vals55/eMeter32/hardware/comparator-board/README.ru.md

# Плата компараторов

[English](README.md) | Русский

Плата импульсных входов для eMeter32. Она преобразует импульсные выходы электросчётчиков в чёткие логические сигналы для ESP32. Основа платы — сдвоенный компаратор **LM393**: по одному компаратору на канал энергии (**E1** и **E2**).

## Как это работает

Электросчётчик сообщает о потреблённой энергии импульсами (например, выход S0 или оптический светодиод). Компаратор превращает эти импульсы в чёткий цифровой сигнал, а ESP32 считает их на аппаратном модуле PCNT. Энергия вычисляется по формуле `кВт·ч = импульсы / константа`, где константа (импульсов на кВт·ч) задаётся в настройках устройства (по умолчанию 3200).

## Схема

Схема платы компараторов

Нажмите на изображение, чтобы открыть схему в PDF.

## Подключение к ESP32

Выходы платы подключаются к выводам, заданным в [`board_config.h`](../../components/board_config/include/board_config.h):

| Сигнал | Вывод ESP32 |
|---|---|
| Выход канала E1 | GPIO 32 |
| Выход канала E2 | GPIO 33 |

У LM393 выходы с открытым коллектором, поэтому прошивка включает внутреннюю подтяжку на обоих входах (`PULSE_PULL_UP`). Счётчик использует аппаратный фильтр помех 10 мкс (`PULSE_GLITCH_NS`) и по умолчанию считает передний фронт (`PULSE_COUNT_FALLING`). Подробнее — в компоненте [`pulse_counter`](../../components/pulse_counter).

## Файлы

| Файл | Описание |
|---|---|
| [`schematic/Schematic_Comparator_2026-10-16.pdf`](schematic/Schematic_Comparator_2026-10-16.pdf) | Принципиальная схема (PDF), от 16.10.2026 |
| [`schematic/Schematic_Comparator_2026-10-16.png`](schematic/Schematic_Comparator_2026-10-16.png) | Принципиальная схема (изображение для README) |
| [`pcb/Gerber_Comparator_PCB_Comparator_2026-10-04.zip`](pcb/Gerber_Comparator_PCB_Comparator_2026-10-04.zip) | Gerber-файлы для производства платы, от 04.10.2026 |

Номиналы компонентов указаны на схеме. Исходники проекта платы в репозиторий не включены.

## Заказ и сборка платы

1. Загрузите Gerber-архив из [`pcb/`](pcb) на производство печатных плат, не распаковывая его (большинство сервисов принимает zip).
2. Закажите компоненты, указанные на [схеме](schematic/Schematic_Comparator_2026-10-16.pdf).
3. Спаяйте плату и проверьте выходы мультиметром или осциллографом, прежде чем подключать её к ESP32.

TODO: размер платы, число слоёв и толщина.

## Настройка счёта

- Число импульсов на кВт·ч указано на вашем счётчике (например, 3200 имп/кВт·ч). Введите его как **Meter constant** в портале настройки или в Home Assistant.
- Если вашему счётчику нужен другой фронт счёта, измените `PULSE_COUNT_FALLING` в `board_config.h`.
- Начальные показания счётчиков можно задать в портале настройки или сущностями **Set energy E1/E2** в Home Assistant.

## Замечания

- Перед подключением проверьте полярность и уровни напряжения импульсных выходов ваших счётчиков: они не должны превышать допустимые для компаратора.
- Плата может подключаться к цепям, близким к **230 В**. Изолируйте её и собирайте, только если знаете правила электробезопасности.

## Лицензия

Файлы проекта платы распространяются под той же [лицензией MIT](../../LICENSE), что и проект.
