vals55/eMeter32/hardware/enclosure/README.ru.md

# Корпус

[English](README.md) | Русский

Корпус для счётчика энергии eMeter32, напечатанный на 3D-принтере. В нём размещаются плата ESP32, модуль PZEM-004T, плата импульсных входов (компараторов) и OLED-дисплей. Корпус рассчитан на обычный FDM-принтер.

eMeter32 в корпусе

> [!WARNING]
> В корпусе находятся детали, подключённые к сети **230 В**. Изолируйте сетевую проводку и отделите её от слаботочной части, а перед включением устройства закройте корпус.

## Файлы

Готовые к печати модели лежат в [`stl/`](stl):

| Файл | Деталь | Кол-во |
|---|---|---|
| [`Pzem-004t_v4_2026-assembly-case.stl`](stl/Pzem-004t_v4_2026-assembly-case.stl) | Корпус (основание) | 1 |
| [`Pzem-004t_v4_2026-assembly-cover.stl`](stl/Pzem-004t_v4_2026-assembly-cover.stl) | Крышка | 1 |
| [`Pzem-004t_v4_2026-assembly-lock.stl`](stl/Pzem-004t_v4_2026-assembly-lock.stl) | Фиксатор | 1 |

## Что размещается внутри

| Деталь | Примечание |
|---|---|
| Плата ESP32 (WEMOS D1 mini ESP32) | Основной контроллер, USB-порт должен оставаться доступным |
| Модуль PZEM-004T | Измерение сети, подключается к сетевой стороне |
| Плата импульсных входов (LM393) | См. [плату компараторов](../comparator-board/README.ru.md) |
| OLED SSD1306, 128×64 | Дисплей состояния |
| Кнопка | Открывает портал настройки (удержание 3 с) |

## Параметры печати

<!-- TODO: заполнить значениями, которые вы использовали -->

| Параметр | Значение |
|---|---|
| Материал | PLA / PETG (PETG лучше для тёплых мест) |
| Высота слоя | 0,2 мм |
| Периметры | 3 |
| Заполнение | 20 % |
| Поддержки | TODO |
| Ориентация | TODO |

## Сборка

1. Напечатайте три детали из [`stl/`](stl).
2. Очистите детали и примерьте платы до окончательной сборки.
3. Установите платы в корпус и закрепите их. TODO: крепёж и размеры.
4. Подключите провода по [распиновке](../../README.ru.md#распиновка).
5. Установите крышку и зафиксируйте её фиксатором. Убедитесь, что ничто не давит на сетевые клеммы.

Если дисплей установлен вверх ногами, установите `OLED_ROTATE_180` в `1` в [`oled.h`](../../components/oled/include/oled.h). У модуля жёлтая зона закреплена сверху, поэтому после поворота она оказывается снизу.

## Лицензия

Модели распространяются под той же [лицензией MIT](../../LICENSE), что и проект.
