vals55/eMeter32/main-readme-blocks.md

# Blocks for the main READMEs

Insert into `README.md` (section "Hardware", after the pinout table) and into `README.ru.md` (section "Аппаратная часть"). Roadmap: mark "Schematics and photos of the device" and "3D-printed enclosure" as done.

## README.md

### Assembly, enclosure and boards

eMeter32 assembled in the enclosure

**Comparator board schematic** (click to open the PDF):

Comparator board schematic

| Item | Location |
|---|---|
| Enclosure (STL models, print and assembly notes) | [`hardware/enclosure`](hardware/enclosure) |
| Comparator board description | [`hardware/comparator-board`](hardware/comparator-board) |
| Schematic (PDF) | [`hardware/comparator-board/schematic/Schematic_Comparator_2026-10-16.pdf`](hardware/comparator-board/schematic/Schematic_Comparator_2026-10-16.pdf) |
| Gerber files for PCB manufacturing | [`hardware/comparator-board/pcb/Gerber_Comparator_PCB_Comparator_2026-10-04.zip`](hardware/comparator-board/pcb/Gerber_Comparator_PCB_Comparator_2026-10-04.zip) |

## README.ru.md

### Сборка, корпус и платы

eMeter32 в корпусе

**Схема платы компараторов** (нажмите, чтобы открыть PDF):

Схема платы компараторов

| Что | Где |
|---|---|
| Корпус (STL-модели, заметки по печати и сборке) | [`hardware/enclosure`](hardware/enclosure/README.ru.md) |
| Описание платы компараторов | [`hardware/comparator-board`](hardware/comparator-board/README.ru.md) |
| Схема (PDF) | [`hardware/comparator-board/schematic/Schematic_Comparator_2026-10-16.pdf`](hardware/comparator-board/schematic/Schematic_Comparator_2026-10-16.pdf) |
| Gerber-файлы для производства платы | [`hardware/comparator-board/pcb/Gerber_Comparator_PCB_Comparator_2026-10-04.zip`](hardware/comparator-board/pcb/Gerber_Comparator_PCB_Comparator_2026-10-04.zip) |
