vals55/eMeter32/hardware/enclosure/stl/Pzem-004t_v4_2026-assembly-cover.stl

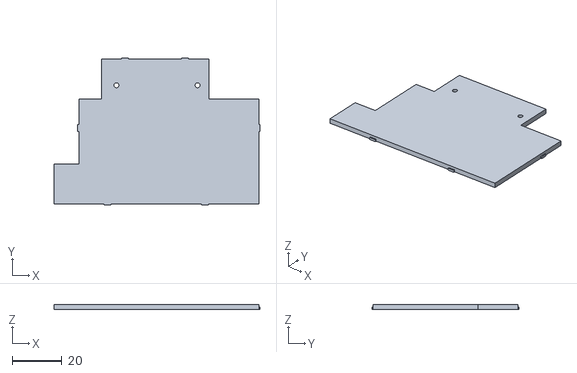
[picture p5: CAD file, 2026-10-18]
hardware/enclosure/stl/Pzem-004t_v4_2026-assembly-cover.stl
82.5 x 59.0 x 2.00
