vals55/eMeter32/hardware/enclosure/stl/Pzem-004t_v4_2026-assembly-lock.stl

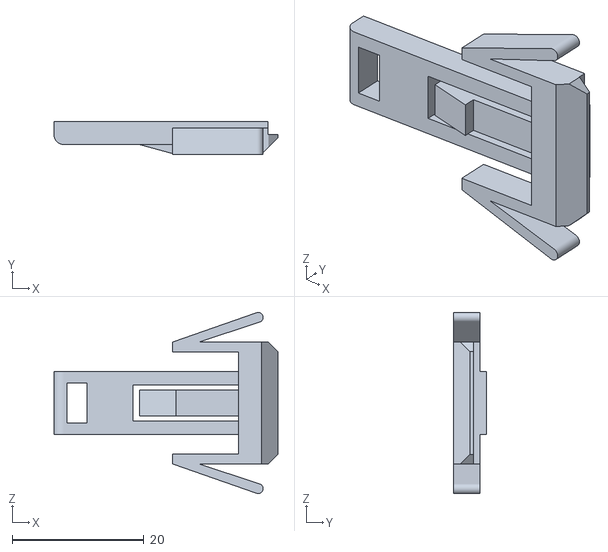
[picture p6: CAD file, 2026-10-16]
hardware/enclosure/stl/Pzem-004t_v4_2026-assembly-lock.stl
34.0 x 5.00 x 27.5
