vals55/eMeter32/hardware/enclosure/stl/Pzem-004t_v4_2026-assembly-case.stl

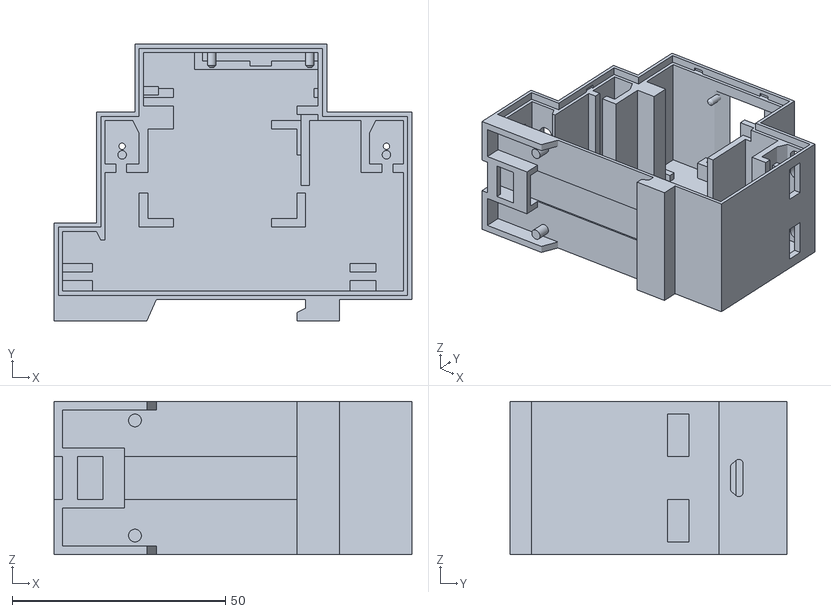
[picture p7: CAD file, 2026-10-16]
hardware/enclosure/stl/Pzem-004t_v4_2026-assembly-case.stl
84.0 x 65.0 x 36.0
