vals55/eMeter32/hardware/comparator-board/schematic/Schematic_Comparator_2026-10-16.pdf

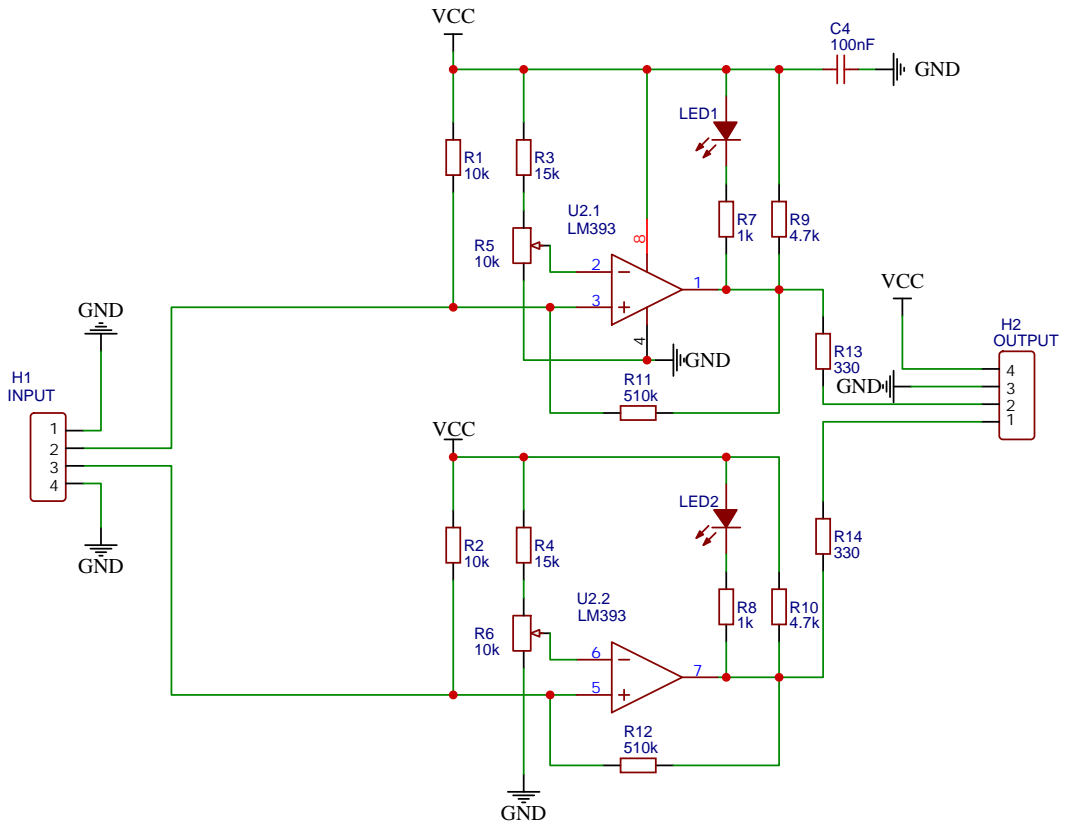
[picture p8: page 1]

Drawn By: Valentin Shokurov
