vals55/eMeter32/components/captive_portal/include/captive_portal.h

// Copyright 2026 vals. All rights reserved.
// SPDX-License-Identifier: MIT
#pragma once
#include "esp_err.h"

/* Запускает точку доступа, DNS-перехват и веб-сервер настроек.
   Можно вызывать из любого контекста (в т.ч. из callback wifi_mgr). */
esp_err_t captive_portal_start(void);

 
 
