vals55/eMeter32/(commit log)

2026-10-12 new edition
    [partitions.csv]
2026-10-16 useful files added
    [Pzem-004t_v4_2026-assembly-case.stl, Pzem-004t_v4_2026-assembly-cover.stl, Pzem-004t_v4_2026-assembly-lock.stl]
2026-10-17 user button fix
    [Pzem-004t_v4_2026-assembly-cover.stl]
2026-10-18 pic fix
    [Pzem-004t_v4_2026-assembly-cover.stl]
2026-11-07 display at start fixed
    [ha_discovery.c, oled.c, pzem004t.c, pzem004t.h]
