vals55/eMeter32/(notices)

Notices in the files:
README.md:
License: MIT
